Gernreich/lyre-harp/lyre-harp-bore30-188x400mm/step/lyre-harp-bore30-188x400mm.step

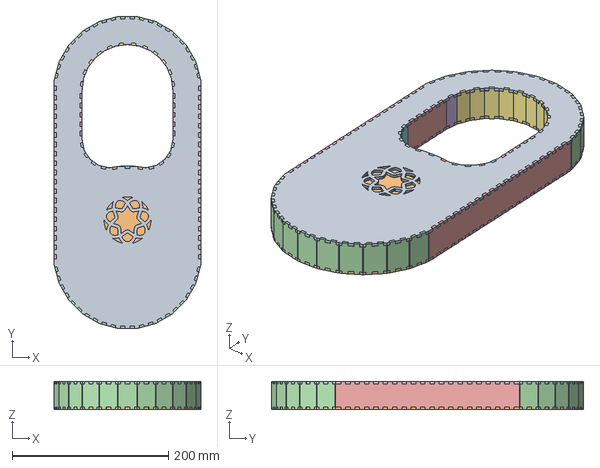
[picture p2: CAD file, 2026-11-09]
lyre-harp-bore30-188x400mm/step/lyre-harp-bore30-188x400mm.step
188.2 x 400.0 x 36.0 mm
