Gernreich/lyre-harp/(commit log)

2026-10-13 Lyre-harp: 400mm seven-string cut files, drawing and 3D page
    Generated by trumpet-elbows-allowed/parts/bore/concept/swept-curve/lyre_harp.py.
2026-10-13 README, published page, previews and .repro
    The writeup and its page, white-ground previews of the five build sheets, a
    Pages workflow, and a .repro claiming all 17 shipped files: every one comes
    out of trumpet-elbows-allowed's lyre_harp.py byte-identical.
2026-10-13 The cheek A preview scales to the page instead of a fixed 720px
    At 400px it pushed the page sideways on a phone. Measured after: the page is
    400px wide in a 400px frame.
2026-10-13 The page links back to the README, not to itself
    The page is built from this README, so 'Read the writeup' pointed at the page
    it was on. Marked readme-only, with a page-only 'Read the README', as
    living-hinge does.
2026-10-14 A photo of the parts as cut: both cheeks, with the pin blocks' laminations
2026-10-14 Page follows the site's theme button
2026-10-19 Bed is 600 x 305mm, cut-tested
    The largest rectangle the xTool P2S cut, tested 2026-10-19, is 600 x 305mm,
    not the 600 x 308 assumed here until now. The largest lyre sheet, 593 x 208, still fits.
2026-10-22 Link back to all projects at the top of the README and the page
    The rest of the build files now points at lasermademusic.html, where the
    instruments moved when the root page became a directory.
2026-10-23 3D view: an ?embed mode, framed bare at the top of the page
    ?embed drops the viewer's own header, key and spec panel, which the writeup
    carries, and keeps the model and its controls. The top's second Turn it in
    3D link is README-only now; the page has the frame and its own link.
2026-11-06 What is on the sheets: no single sheet is 593 x 208mm; name the widest and the tallest
2026-11-07 Call lasermade-tools' Rust programs, not its Python scripts
    The tools became Rust on 2026-11-07: target/release/<name> in lasermade-tools
    (cargo build --release there) replaces python3 <name>.py, in commands,
    manifests and prose. Pages rebuilt; no generated file changes otherwise.
2026-11-08 lyre_harp in Rust; the Python goes
    Every sheet, test sheet, the back-face engraving, the drawing and the 3D page
    come out byte-identical to lyre_harp.py's (16 runs, 66 files, the --fit
    refusals included); the drawing now says it is drawn from lyre_harp.rs. Its
    panels, slots and sheets are swept-curve's ribbon_bore library, the one cheek
    cut as two through sheet_items(). .repro runs target/release/lyre_harp.
2026-11-08 STEP files of the 3D view, for a CAD program
    One file per design in step/, one solid body per part, written from the
    3D page by lasermade-tools step-export and checked by .repro. Every file
    opens in SolidCraft with every body closed and no warnings.
    [lyre-harp-bore30-188x400mm.step]
2026-11-08 Parametric SolidCraft design; the STEP built by SolidCraft
    lyre_solidcraft.rs writes the frame as a SolidCraft script (lyre_harp
    --solidcraft=DIR): every point of the 3D view is a read-only parameter worked
    out from length, width, bore, ply, the hole's proportions and the fit, as the
    generator works it out, and checked against the generator's own numbers before
    it is written. Checked part by part: 63 parts within 0.001 mm, and the same at
    --fit=0.20 and at 420 mm, a 28 mm bore and 3.2 mm ply.
    [lyre-harp-bore30-188x400mm.step]
2026-11-09 SolidCraft design: finger joints and mortices; it reads back
    The panels have their teeth and both cheeks their mortices, through
    ribbon_bore's joints(): each panel as many teeth as its length holds,
    the mortices and the play following --fit. The cheeks' rims are as cut,
    half a kerf inside the drawn line, checked against the generator's.
    sc-flatten --redraw-all now lands all 63 parts on the committed cut
    files: cuts within 0.026 mm, marks within 0.123 mm.
    [lyre-harp-bore30-188x400mm.step]
